mfoster0/PlantMon/img/RechargerCheck.jpg

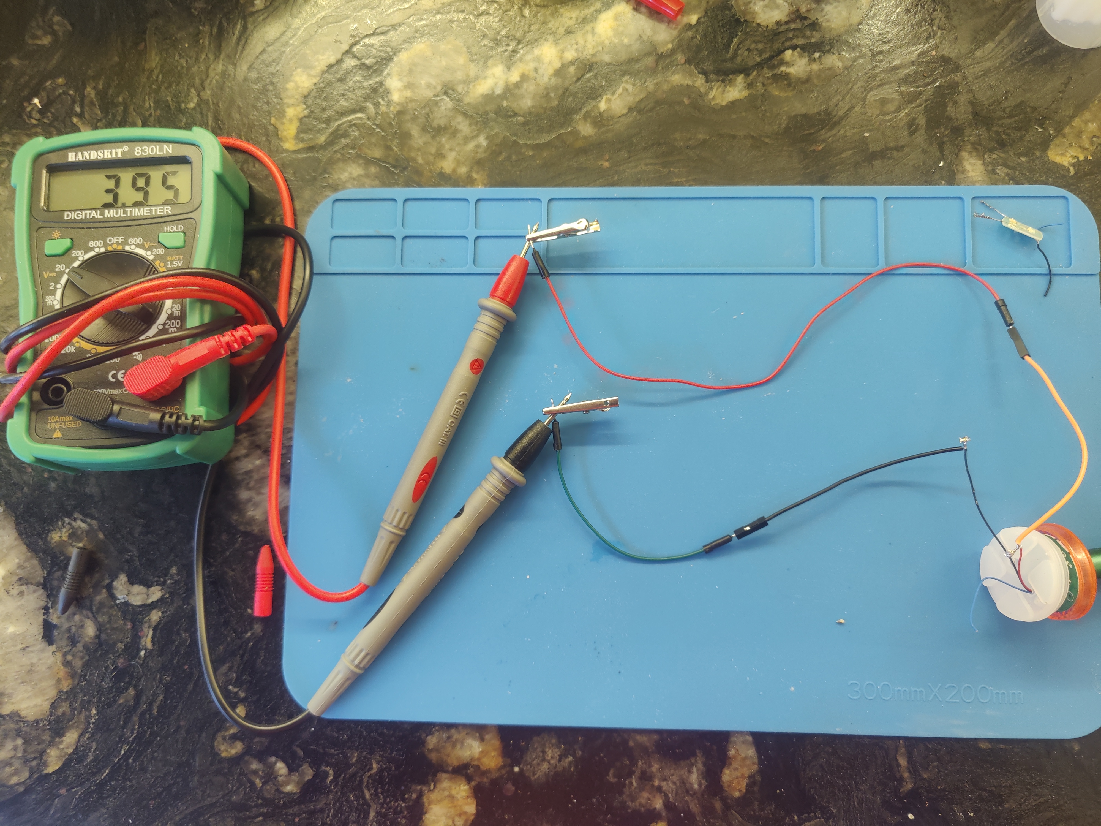
img/RechargerCheck.jpg
