mfoster0/PlantMon/(commit log)

2023-10-31 Testing sensor and mapping working
    Nail sensor is working but the readings are not sensitive. Updated readings to use map to show from 1 to 10 as the range
2023-10-31 Remote control working and general housekeeping
    Resolved remote control issue. Still to be developed but topics now functioning correctly
    [PlantMon.ino]
2023-10-31 Merged moisture test script with main
    1 issue to resolve. Moisture test script is detecting the sensor values correctly. When copied into the main script the values are close to zero.
    [PlantMon.ino]
2023-11-01 HTML amend for webserver. MQTT time & checksum
    Added accessibility tags, basic formatting, placeholder buttons for controls.
    Added the topics and data for the message time and checksum. Checksum is currently a placeholder
2023-11-01 Added data flows jpg
2023-11-06 Clean up of MoistureTest script
    Altered the set up so that moisture readings are no longer mapped. The cipher is now is now used. Message times are published
    [MoistureTest.ino, MultipleWifi.ino, PlantMon.ino]
2023-11-14 Tests for buzzer and deep sleep
    Using free pins for buzzer and low power modes
    [BuzzerAndDeepSleep.ino]
2023-11-15 Added health alert code
    Added the buzzer and led alerts for health problems
    [PlantMon.ino]
2023-11-16 Sleep mode
    Trying out different delay and sleep modes to conserve power and maintain adequate server connections
2023-11-16 Merged code for remote control of device
    Using MQTT for remote control
